pierregoge/Turtle-tracker-tag/Hardware/Image/turtle_tag.png

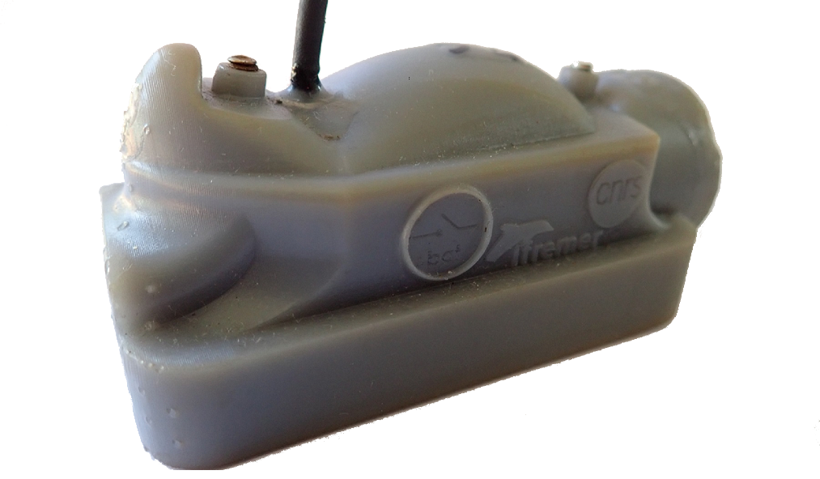
Hardware/Image/turtle_tag.png
