pierregoge/Turtle-tracker-tag/Hardware/Image/3D_02.PNG

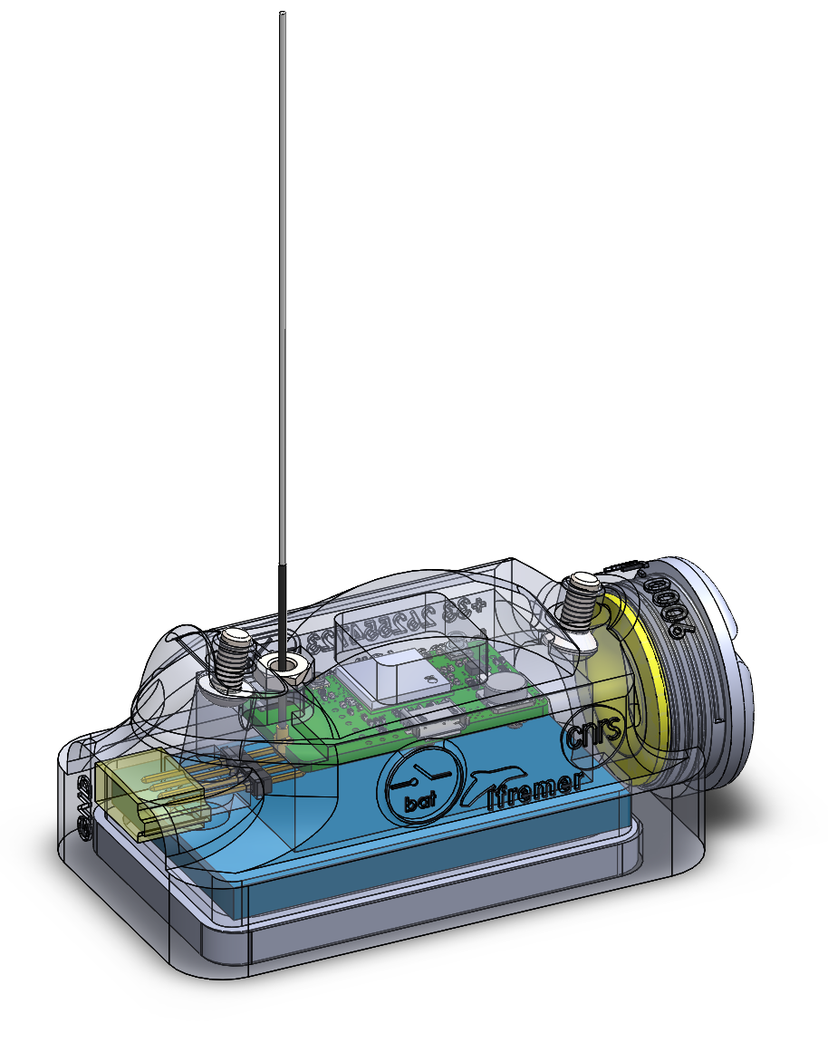
Hardware/Image/3D_02.PNG
