pierregoge/Turtle-tracker-tag/Hardware/Image/back_01.PNG

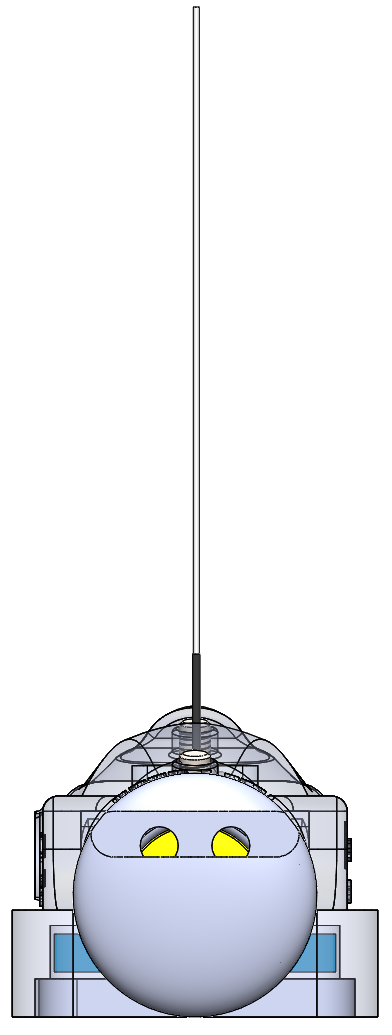
Hardware/Image/back_01.PNG
