pierregoge/Turtle-tracker-tag/Hardware/Image/back_02.PNG

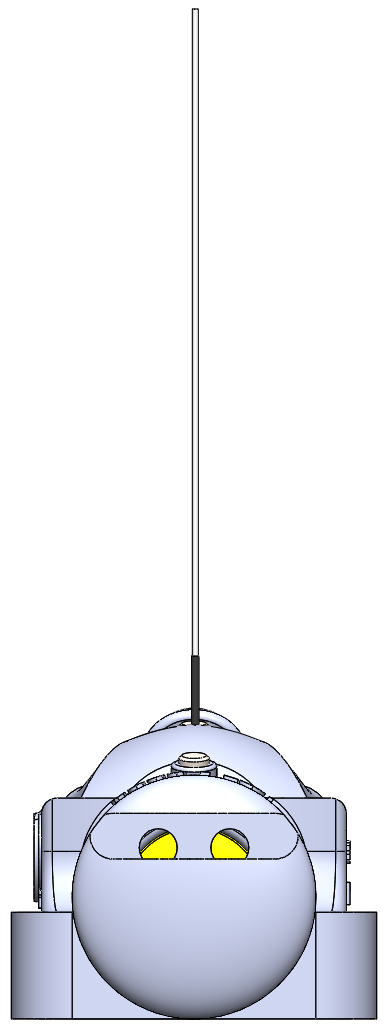
Hardware/Image/back_02.PNG
