pierregoge/Turtle-tracker-tag/Hardware/Image/cut_01.PNG

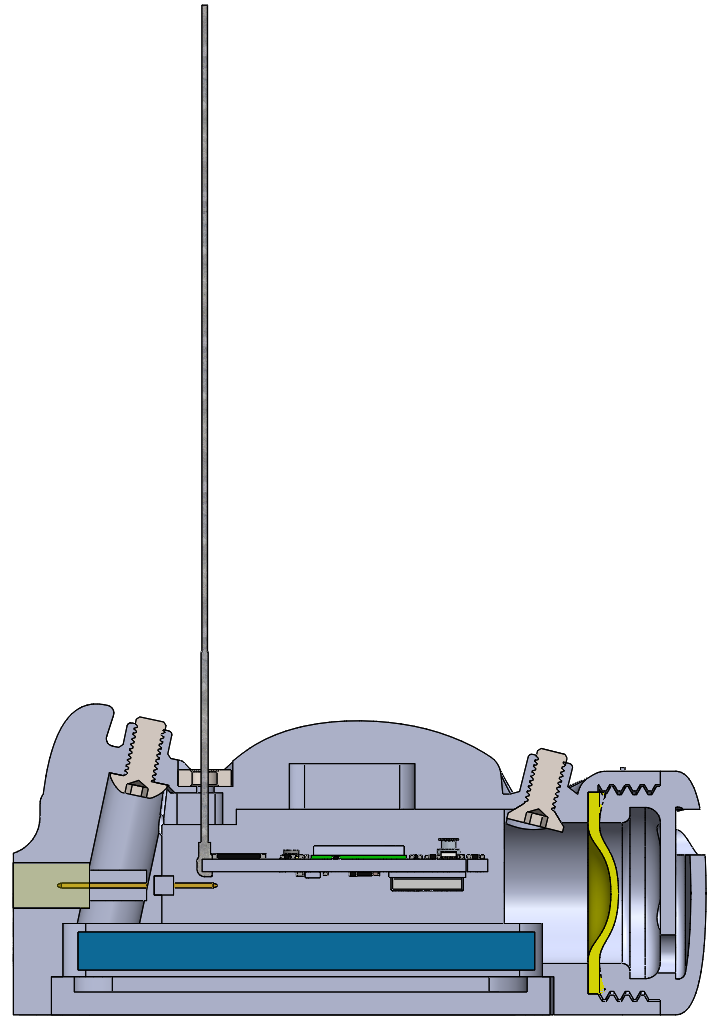
Hardware/Image/cut_01.PNG
