pierregoge/Turtle-tracker-tag/Hardware/Image/rigth_01.PNG

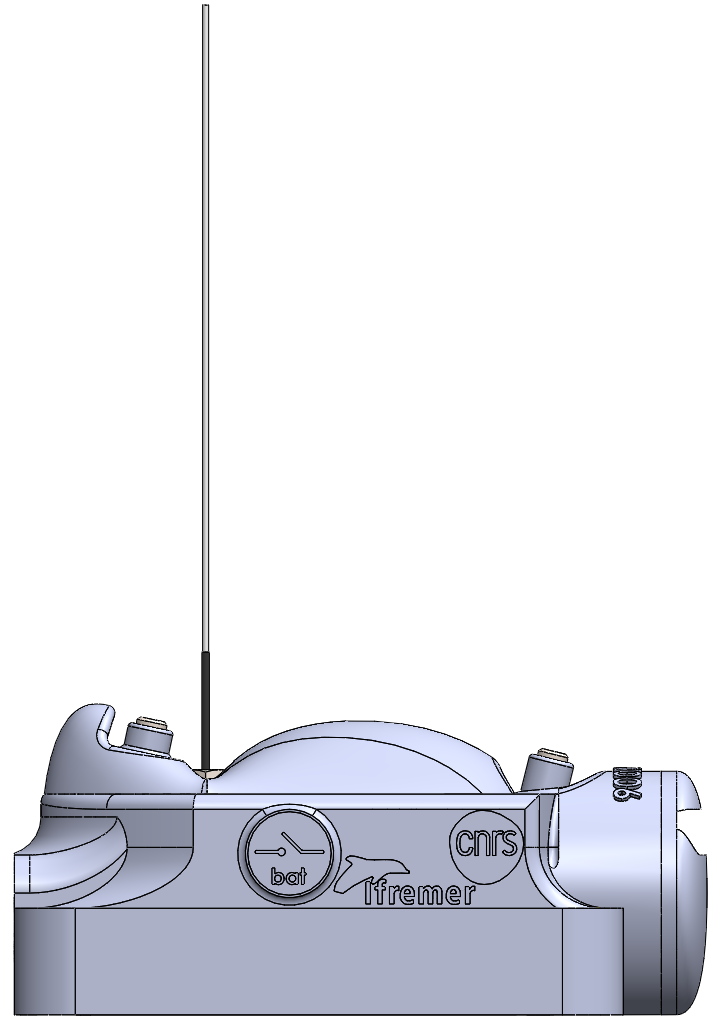
Hardware/Image/rigth_01.PNG
