pierregoge/Turtle-tracker-tag/Hardware/Image/rigth_02.PNG

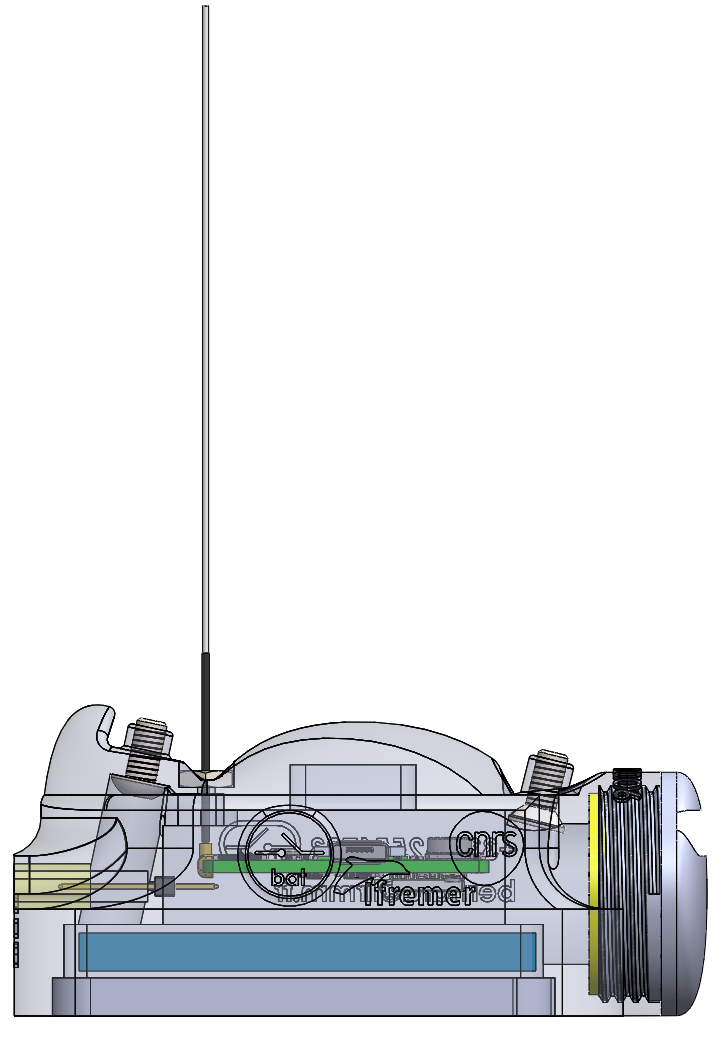
Hardware/Image/rigth_02.PNG
