pierregoge/Turtle-tracker-tag/Hardware/CAO/bouchon.SLDPRT

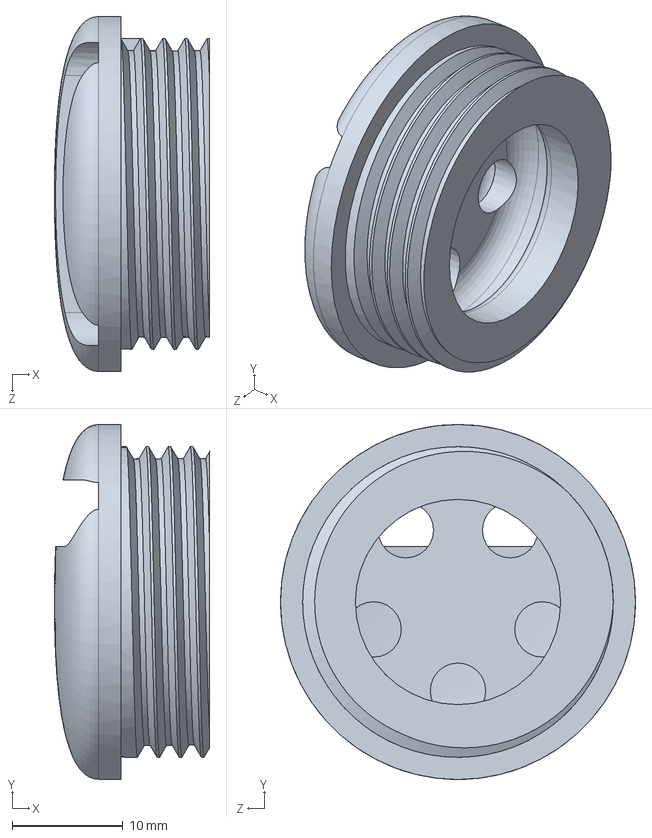
[picture p9: CAD file, 2022-09-29]
Hardware/CAO/bouchon.SLDPRT
14.0 x 32.0 x 32.0 mm
