pierregoge/Turtle-tracker-tag/Hardware/CAO/bouchon_silicone.SLDPRT

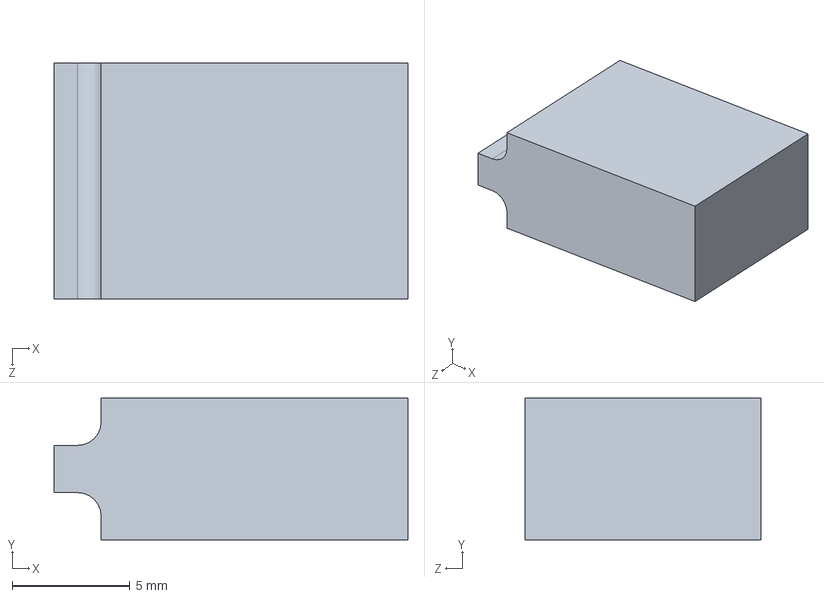
[picture p10: CAD file, 2022-09-29]
Hardware/CAO/bouchon_silicone.SLDPRT
15.0 x 6.00 x 10.0 mm
