pierregoge/Turtle-tracker-tag/Hardware/CAO/dock.SLDPRT

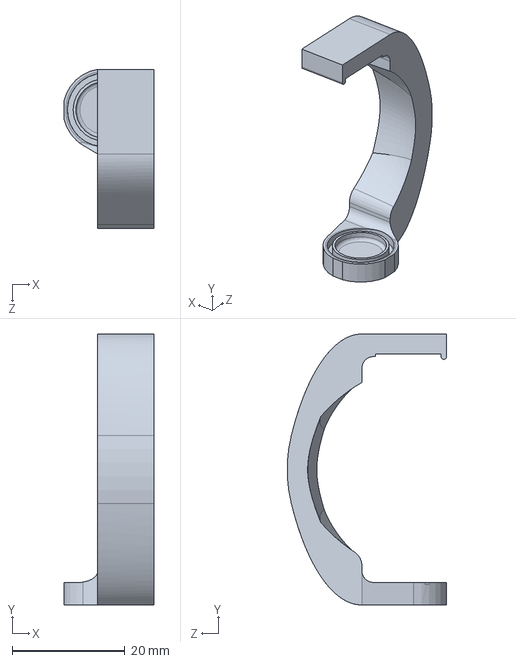
[picture p11: CAD file, 2022-09-29]
Hardware/CAO/dock.SLDPRT
16.0 x 48.0 x 28.2 mm
