pierregoge/Turtle-tracker-tag/Hardware/CAO/plaque_dessous.SLDPRT

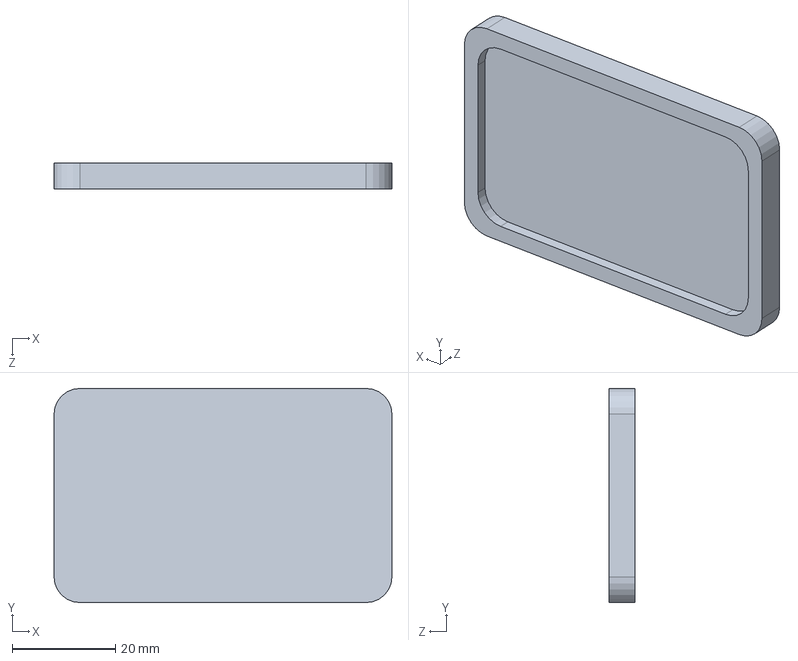
[picture p12: CAD file, 2022-09-29]
Hardware/CAO/plaque_dessous.SLDPRT
65.5 x 41.5 x 5.00 mm
