pierregoge/Turtle-tracker-tag/Hardware/CAO/4pin_251-8351.SLDPRT

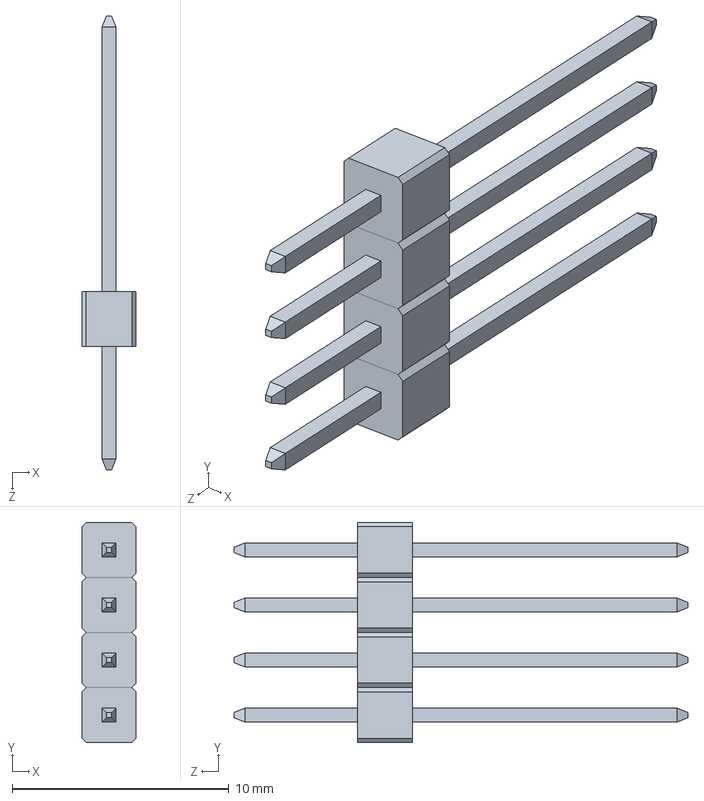
[picture p13: CAD file, 2022-09-29]
Hardware/CAO/4pin_251-8351.SLDPRT
2.50 x 10.2 x 20.9 mm
