pierregoge/Turtle-tracker-tag/Hardware/CAO/plan_de_masse.SLDPRT

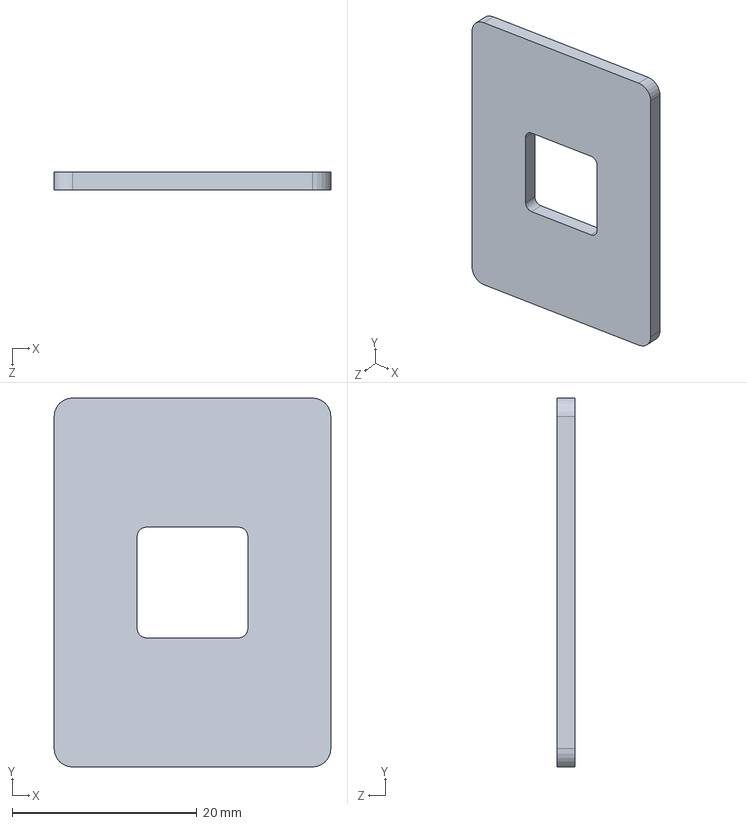
[picture p14: CAD file, 2022-09-29]
Hardware/CAO/plan_de_masse.SLDPRT
30.0 x 40.0 x 2.00 mm
