pierregoge/Turtle-tracker-tag/Hardware/CAO/Passive_GPS_Antenna_uFL-15mm-15mm.SLDPRT

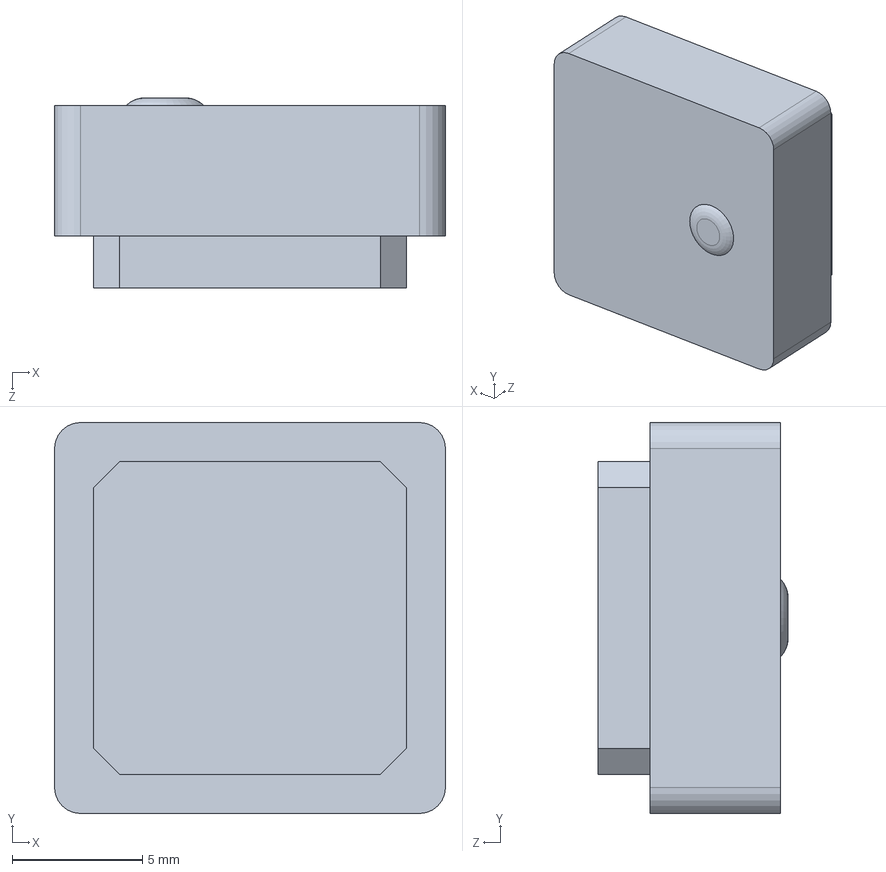
[picture p15: CAD file, 2022-09-29]
Hardware/CAO/Passive_GPS_Antenna_uFL-15mm-15mm.SLDPRT
15.0 x 15.0 x 7.30 mm
