pierregoge/Turtle-tracker-tag/Hardware/CAO/membrane.SLDPRT

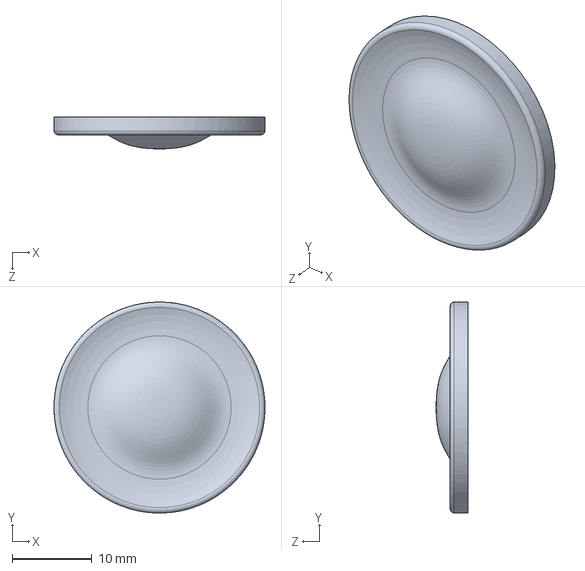
[picture p16: CAD file, 2022-09-29]
Hardware/CAO/membrane.SLDPRT
26.5 x 26.5 x 4.00 mm
