pierregoge/Turtle-tracker-tag/Hardware/CAO/protec.SLDPRT

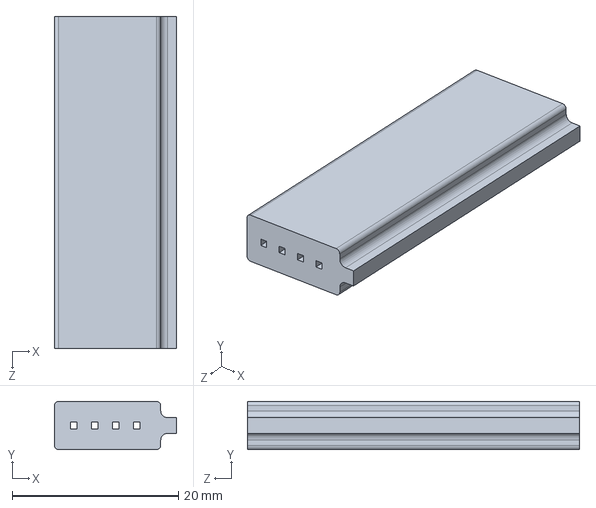
[picture p17: CAD file, 2022-09-29]
Hardware/CAO/protec.SLDPRT
14.7 x 5.80 x 40.0 mm
