pierregoge/Turtle-tracker-tag/Hardware/CAO/7pin_251-8351.SLDPRT

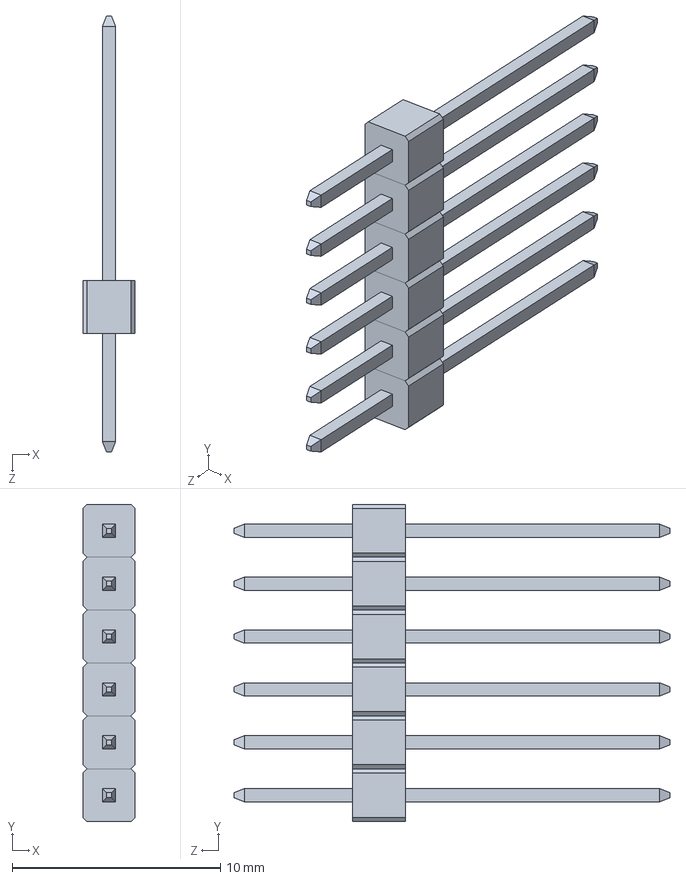
[picture p18: CAD file, 2022-09-29]
Hardware/CAO/7pin_251-8351.SLDPRT
2.50 x 15.2 x 20.9 mm
