pierregoge/Turtle-tracker-tag/Hardware/CAO/0006.SLDPRT

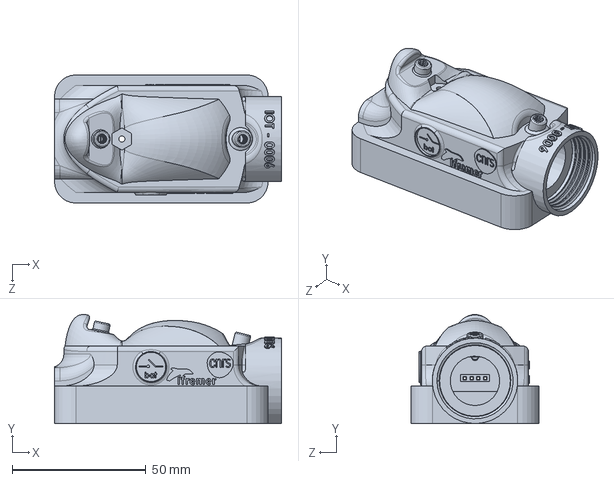
[picture p19: CAD file, 2022-09-29]
Hardware/CAO/0006.SLDPRT
85.0 x 40.8 x 48.0 mm
