pierregoge/Turtle-tracker-tag/Hardware/CAO/battery_1300mAh.SLDPRT

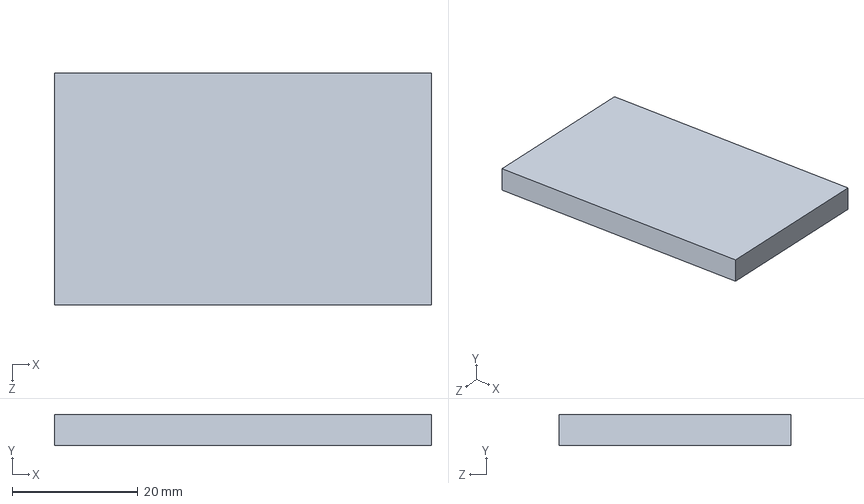
[picture p20: CAD file, 2022-09-29]
Hardware/CAO/battery_1300mAh.SLDPRT
60.0 x 5.00 x 37.0 mm
