pierregoge/Turtle-tracker-tag/Hardware/CAO/MEP.pdf

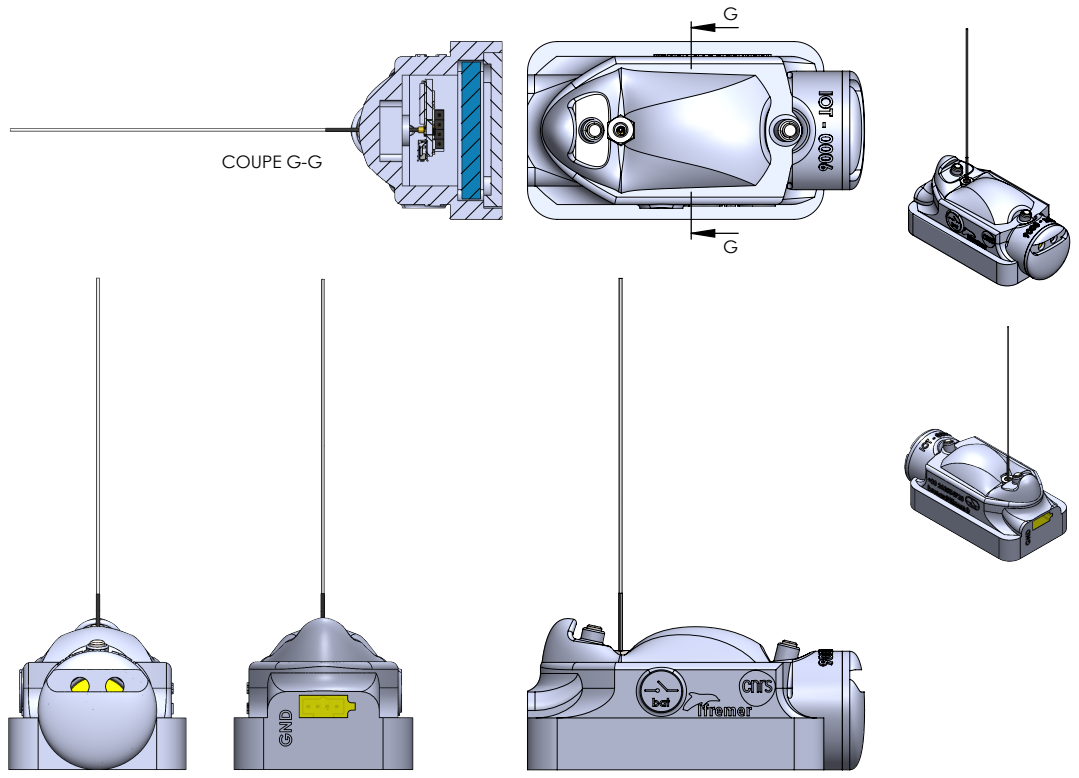
[picture p21: page 1]
COUPE G-G
