pierregoge/Turtle-tracker-tag/Schematic_and_PCB/Turtle_Tracker_V1b/PCB_IoT.Gnat.v01b_Bottom.pdf

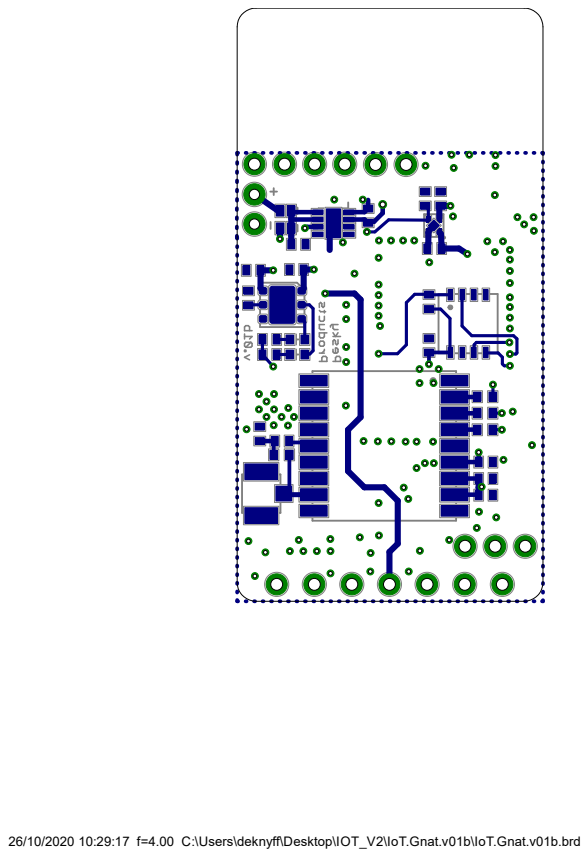
[picture p22: page 1]

26/10/2020 10:29:17 f=4.00 C:\Users\deknyff\Desktop\IOT_V2\IoT.Gnat.v01b\IoT.Gnat.v01b.brd
