pierregoge/Turtle-tracker-tag/Schematic_and_PCB/Turtle_Tracker_V1b/PCB_IoT.Gnat.v01b_Top.pdf

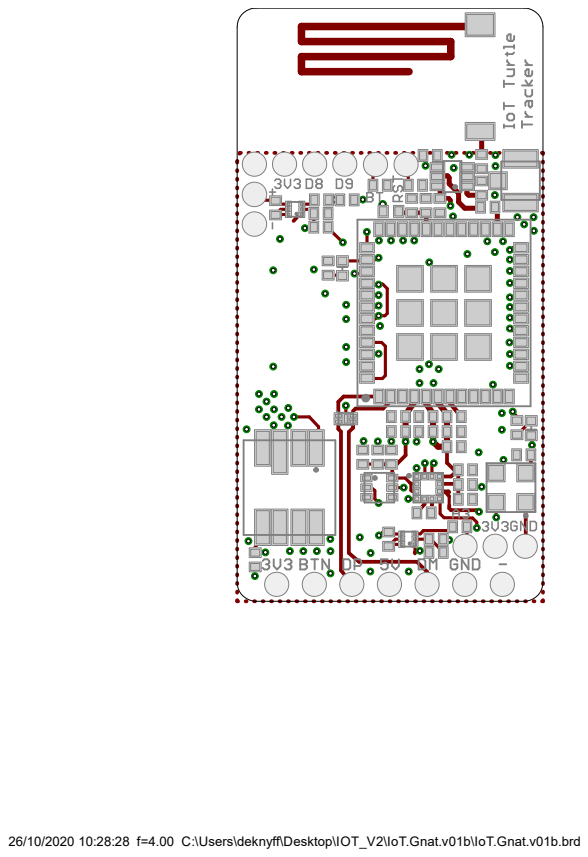
[picture p23: page 1]

26/10/2020 10:28:28 f=4.00 C:\Users\deknyff\Desktop\IOT_V2\IoT.Gnat.v01b\IoT.Gnat.v01b.brd
