pierregoge/Turtle-tracker-tag/Schematic_and_PCB/Turtle_Tracker_V1b/schema_IoT.Gnat.v01b_#1.pdf

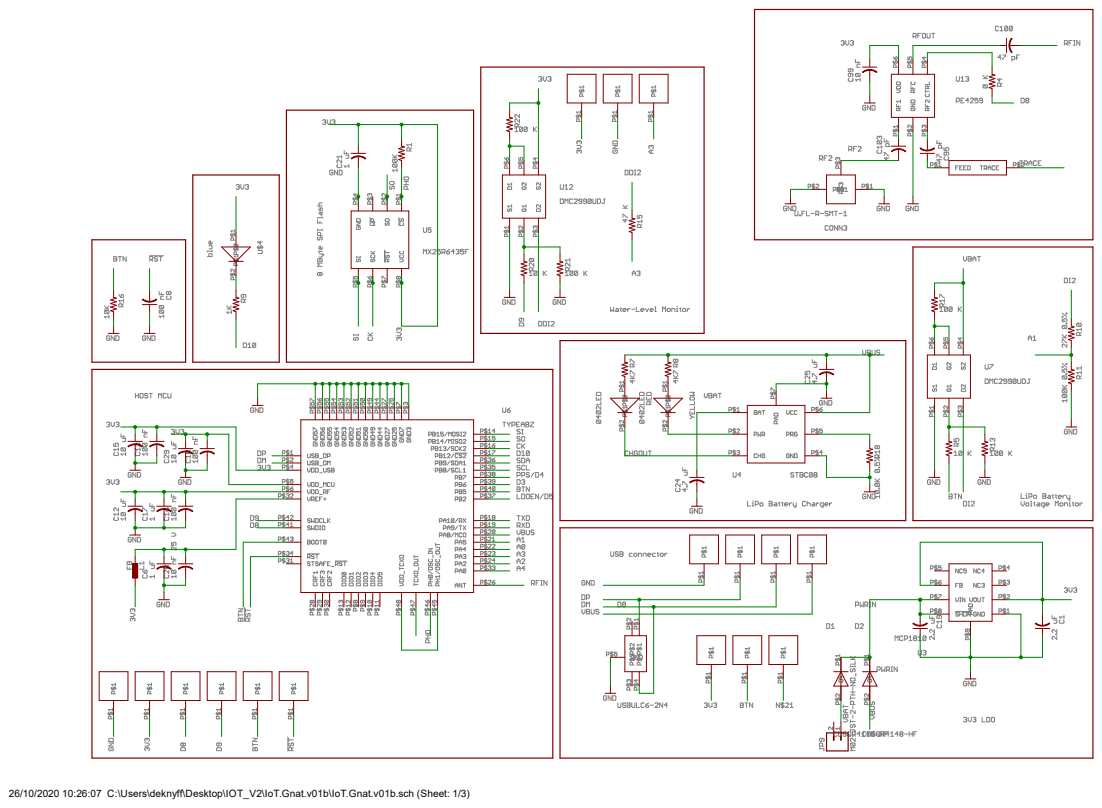
[picture p24: page 1]

26/10/2020 10:26:07 C:\Users\deknyff\Desktop\IOT_V2\IoT.Gnat.v01b\IoT.Gnat.v01b.sch (Sheet: 1/3)
