pierregoge/Turtle-tracker-tag/Schematic_and_PCB/Turtle_Tracker_V1b/schema_IoT.Gnat.v01b_#2.pdf

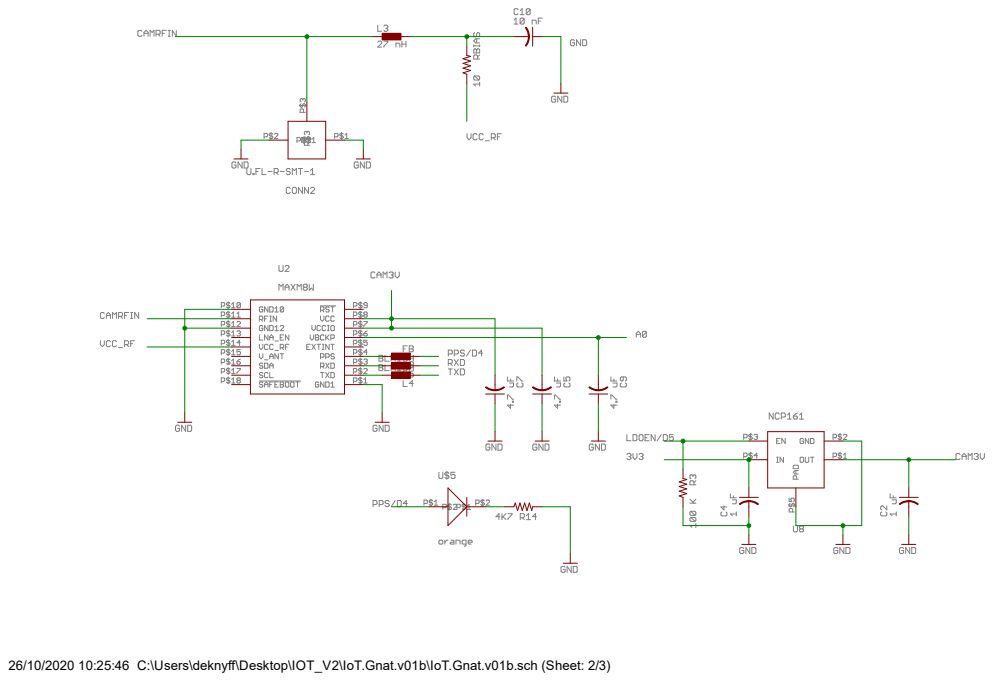
[picture p25: page 1]

26/10/2020 10:25:46 C:\Users\deknyff\Desktop\IOT_V2\IoT.Gnat.v01b\IoT.Gnat.v01b.sch (Sheet: 2/3)
