pierregoge/Turtle-tracker-tag/Schematic_and_PCB/Turtle_Tracker_V1b/schema_IoT.Gnat.v01b_#3.pdf

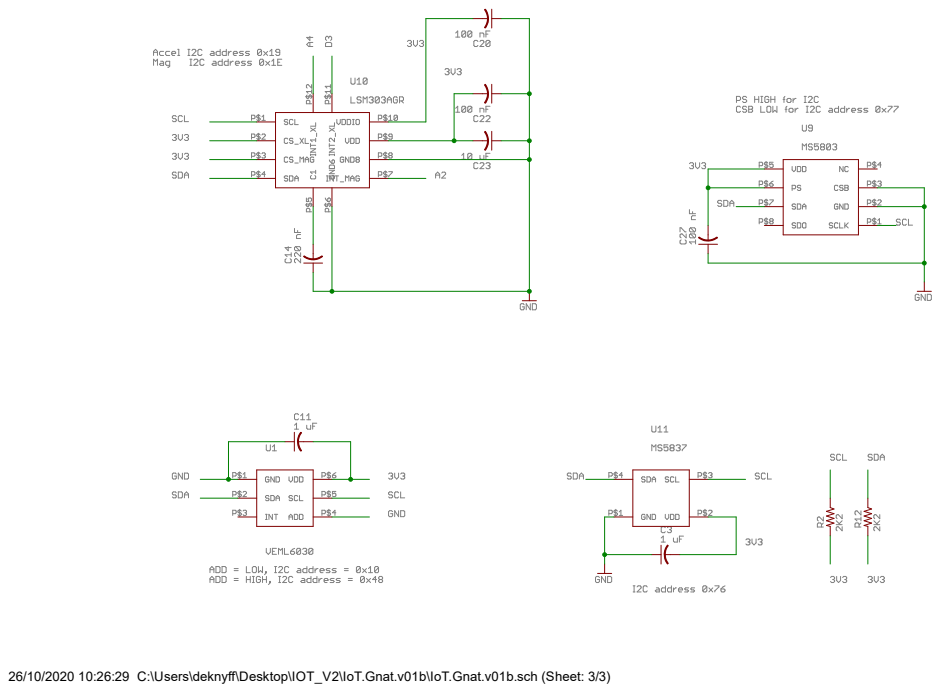
[picture p26: page 1]

26/10/2020 10:26:29 C:\Users\deknyff\Desktop\IOT_V2\IoT.Gnat.v01b\IoT.Gnat.v01b.sch (Sheet: 3/3)
