pierregoge/Turtle-tracker-tag/Hardware/CAO/parametres.txt

"a"=20mm

"b"=50mm

"c"=33mm

"d"=32mm

"e"=1mm

"n"=1.5

"theta"=(45/360)*2*3.1415926
