pierregoge/Turtle-tracker-tag/Analysis/post_proccessing/trajectories_computing/post_pro_matlab.jpg

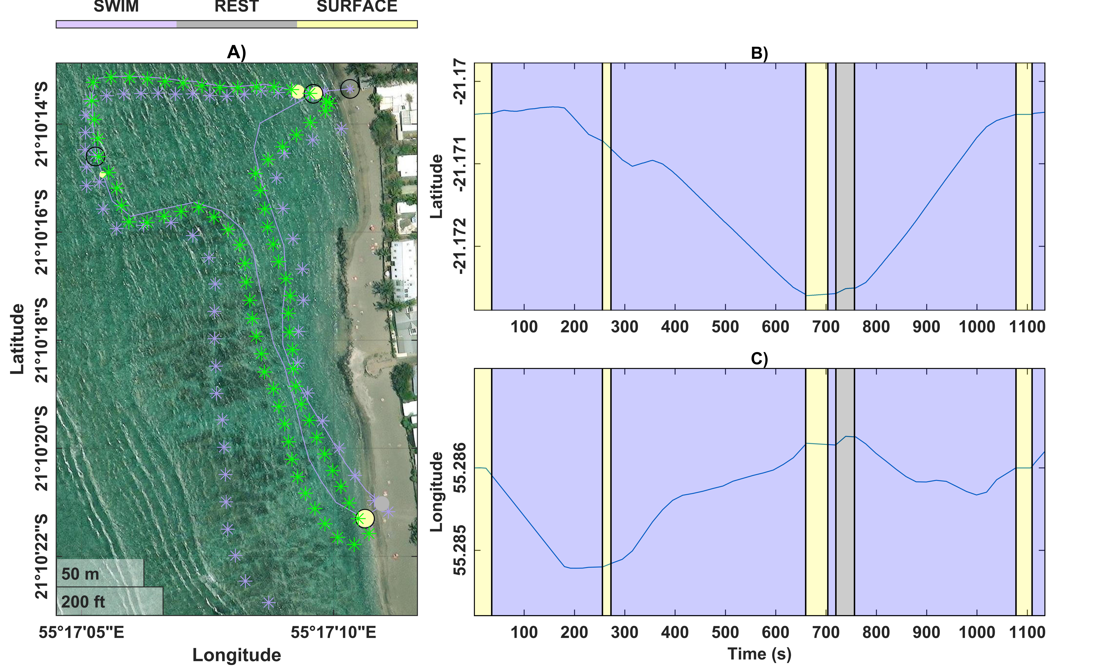
Analysis/post_proccessing/trajectories_computing/post_pro_matlab.jpg
